jgartrel/arduino-nano-avr-controller/(commit log)

2019-01-07 Change pin assignments
2019-01-07 LED now shows the state of the mute signal
2019-01-07 Remove powerSignal since device will be powered by the switch
2019-01-07 Add appropriate delay to allow receiver to power on fully
2019-01-15 Move Remote Control Out to pin D3
2019-01-15 Invert statemachine, mute on the audio switch is LOW
    [avr_controller.ino]
2019-01-19 Add 220 Ohm resistor to protect the nano.
